chschu/buttonbox/hardware/controller.kicad_pcb

## KiCad design hardware/controller.kicad_pcb (2020-08-22)

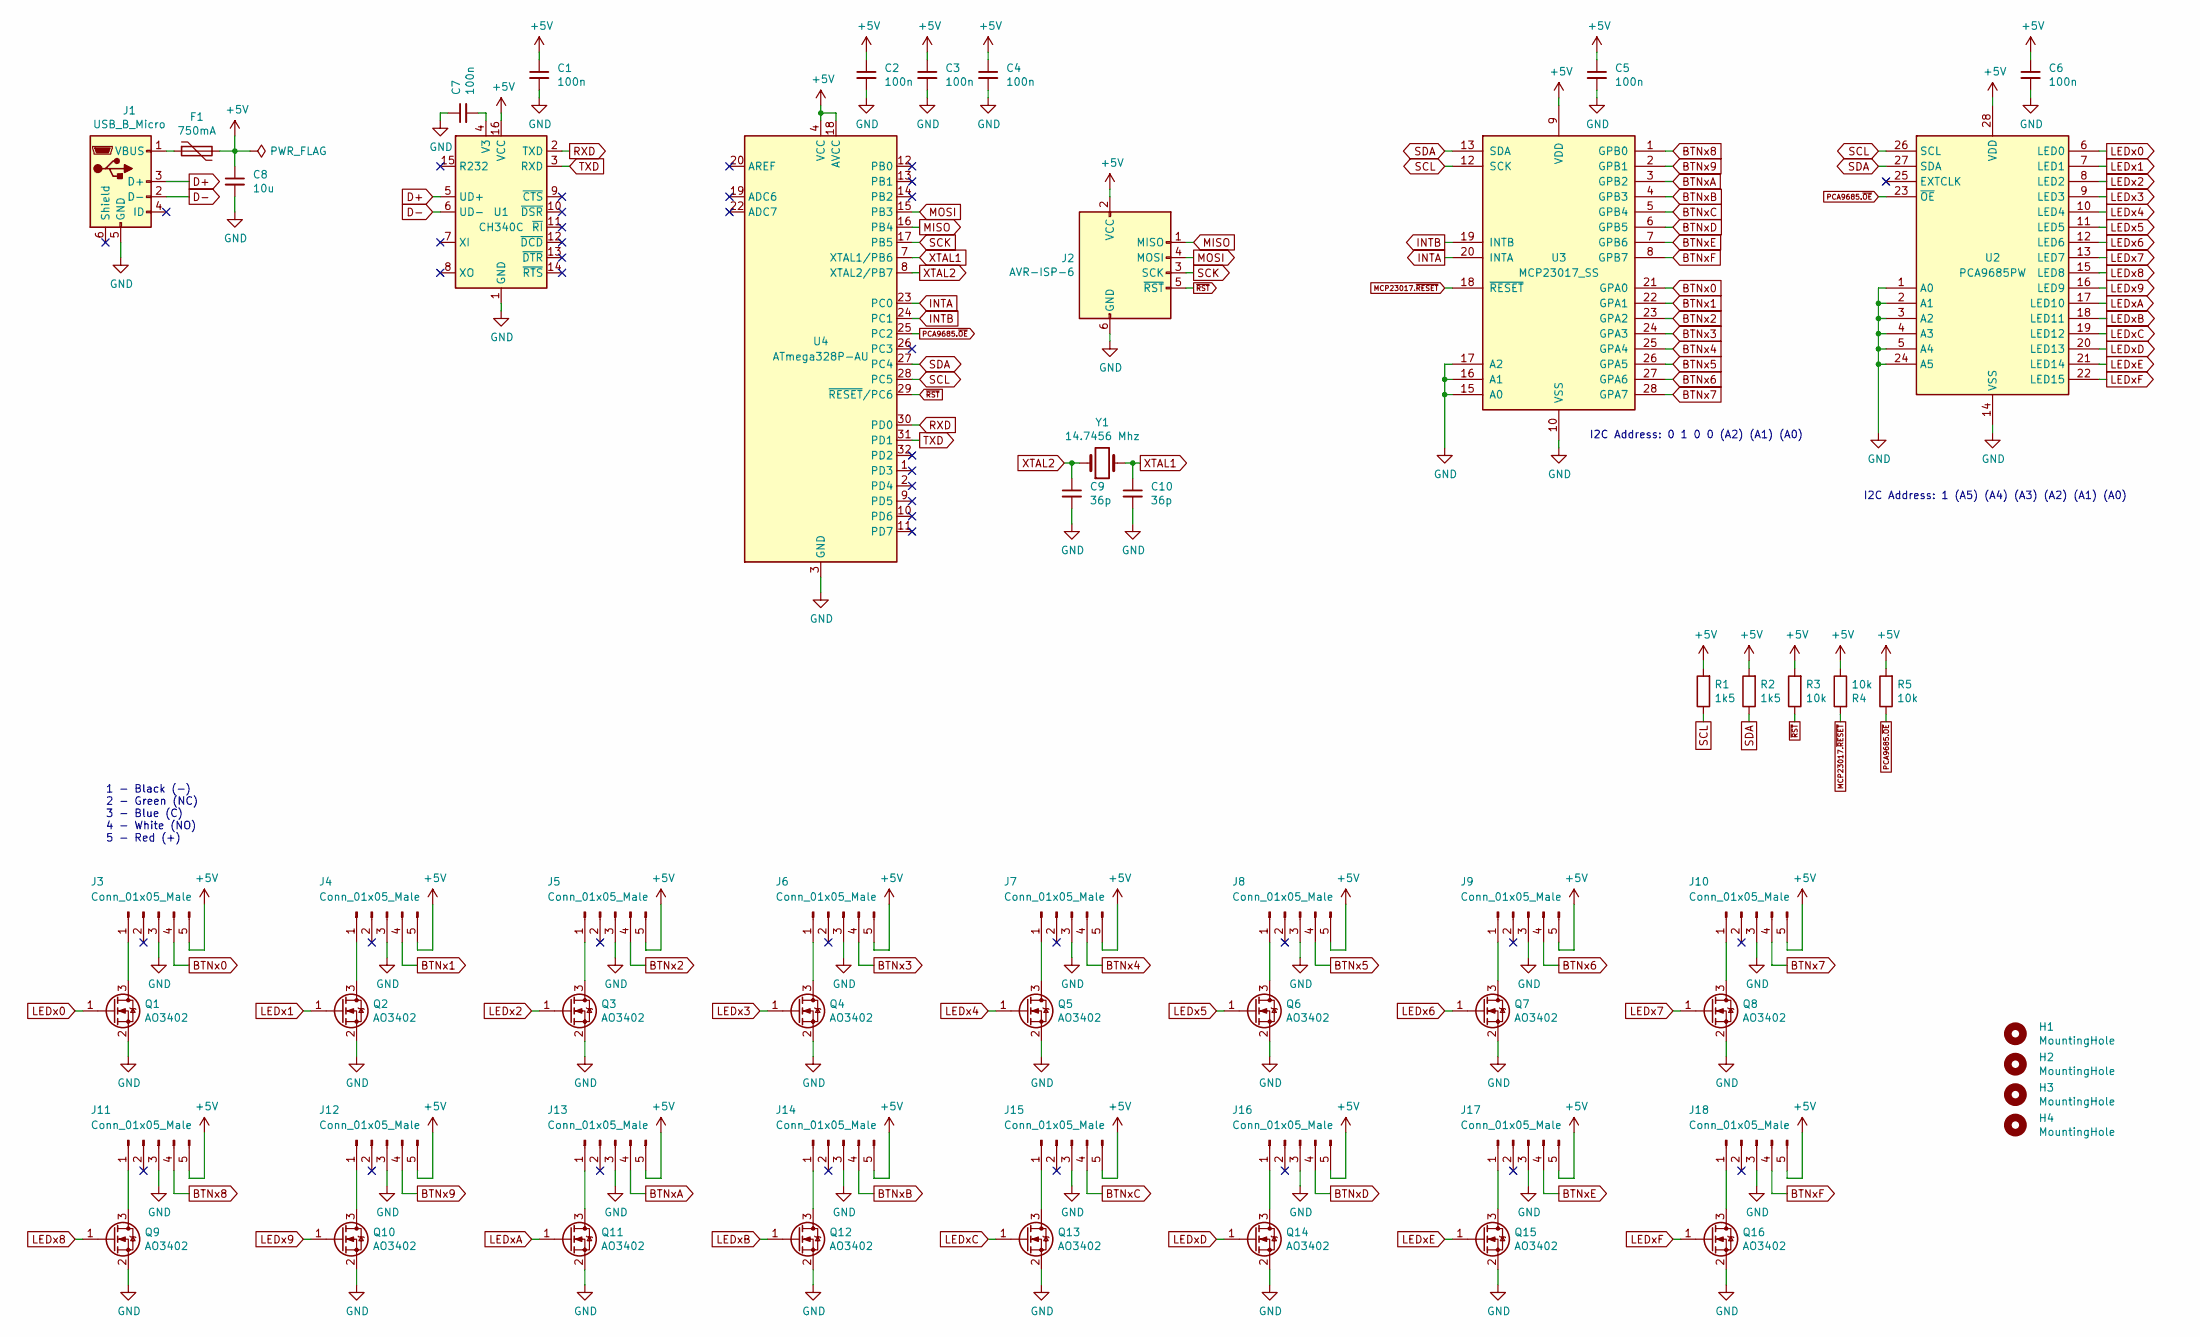
[picture p1: schematic controller.sch]

Parts:
C1, C2, C3, C4, C5, C6, C7: 100n; C_0805_2012Metric
C8: 10u; C_Disc_D6.0mm_W2.5mm_P5.00mm
C9, C10: 36p; C_0805_2012Metric
F1: 750mA; Fuse_0805_2012Metric
H1, H2, H3, H4: MountingHole; MountingHole_3.5mm
J1: USB_B_Micro; USB_Micro-B_Molex-105017-0001
J2: AVR-ISP-6; PinHeader_2x03_P2.54mm_Vertical
J3, J4, J5, J6, J7, J8, J9, J10, J11, J12, J13, J14, J15, J16, J17, J18: Conn_01x05_Male; JST_XH_B5B-XH-A_1x05_P2.50mm_Vertical
Q1, Q2, Q3, Q4, Q5, Q6, Q7, Q8, Q9, Q10, Q11, Q12, Q13, Q14, Q15, Q16: AO3402; SOT-23
R1, R2: 1k5; R_0805_2012Metric
R3, R4, R5: 10k; R_0805_2012Metric
U1: CH340C; SOIC-16_3.9x9.9mm_P1.27mm
U2: PCA9685PW; TSSOP-28_4.4x9.7mm_P0.65mm
U3: MCP23017_SS; SSOP-28_5.3x10.2mm_P0.65mm
U4: ATmega328P-AU; TQFP-32_7x7mm_P0.8mm
Y1: 14.7456 Mhz; Crystal_SMD_HC49-SD

Connections:
+5V: C1.1, C2.1, C3.1, C4.1, C5.1, C6.1, C8.1, F1.2, J2.2 (VCC), J3.5, J4.5, J5.5, J6.5, J7.5, J8.5, J9.5, J10.5, J11.5, J12.5, J13.5, J14.5, J15.5, J16.5, J17.5, J18.5, R1.2, R2.2, R3.2, R4.1, R5.2, U1.16 (VCC), U2.28 (VDD), U3.9 (VDD), U4.4 (VCC), U4.6 (VCC), U4.18 (AVCC)
BTNx0: J3.4, U3.21 (GPA0)
BTNx1: J4.4, U3.22 (GPA1)
BTNx2: J5.4, U3.23 (GPA2)
BTNx3: J6.4, U3.24 (GPA3)
BTNx4: J7.4, U3.25 (GPA4)
BTNx5: J8.4, U3.26 (GPA5)
BTNx6: J9.4, U3.27 (GPA6)
BTNx7: J10.4, U3.28 (GPA7)
BTNx8: J11.4, U3.1 (GPB0)
BTNx9: J12.4, U3.2 (GPB1)
BTNxA: J13.4, U3.3 (GPB2)
BTNxB: J14.4, U3.4 (GPB3)
BTNxC: J15.4, U3.5 (GPB4)
BTNxD: J16.4, U3.6 (GPB5)
BTNxE: J17.4, U3.7 (GPB6)
BTNxF: J18.4, U3.8 (GPB7)
D+: J1.3 (D+), U1.5 (UD+)
D-: J1.2 (D-), U1.6 (UD-)
GND: C1.2, C2.2, C3.2, C4.2, C5.2, C6.2, C7.1, C8.2, C9.2, C10.2, J1.5 (GND), J2.6 (GND), J3.3, J4.3, J5.3, J6.3, J7.3, J8.3, J9.3, J10.3, J11.3, J12.3, J13.3, J14.3, J15.3, J16.3, J17.3, J18.3, Q1.2 (S), Q2.2 (S), Q3.2 (S), Q4.2 (S), Q5.2 (S), Q6.2 (S), Q7.2 (S), Q8.2 (S), Q9.2 (S), Q10.2 (S), Q11.2 (S), Q12.2 (S), Q13.2 (S), Q14.2 (S), Q15.2 (S), Q16.2 (S), U1.1 (GND), U2.1 (A0), U2.2 (A1), U2.3 (A2), U2.4 (A3), U2.5 (A4), U2.14 (VSS), U2.24 (A5), U3.10 (VSS), U3.15 (A0), U3.16 (A1), U3.17 (A2), U4.3 (GND), U4.5 (GND), U4.21 (GND)
INTA: U3.20 (INTA), U4.23 (PC0)
INTB: U3.19 (INTB), U4.24 (PC1)
LEDx0: Q1.1 (G), U2.6 (LED0)
LEDx1: Q2.1 (G), U2.7 (LED1)
LEDx2: Q3.1 (G), U2.8 (LED2)
LEDx3: Q4.1 (G), U2.9 (LED3)
LEDx4: Q5.1 (G), U2.10 (LED4)
LEDx5: Q6.1 (G), U2.11 (LED5)
LEDx6: Q7.1 (G), U2.12 (LED6)
LEDx7: Q8.1 (G), U2.13 (LED7)
LEDx8: Q9.1 (G), U2.15 (LED8)
LEDx9: Q10.1 (G), U2.16 (LED9)
LEDxA: Q11.1 (G), U2.17 (LED10)
LEDxB: Q12.1 (G), U2.18 (LED11)
LEDxC: Q13.1 (G), U2.19 (LED12)
LEDxD: Q14.1 (G), U2.20 (LED13)
LEDxE: Q15.1 (G), U2.21 (LED14)
LEDxF: Q16.1 (G), U2.22 (LED15)
MCP23017.~RESET: R4.2, U3.18 (~RESET~)
MISO: J2.1 (MISO), U4.16 (PB4)
MOSI: J2.4 (MOSI), U4.15 (PB3)
unnamed: C7.2, U1.4 (V3)
unnamed: F1.1, J1.1 (VBUS)
unnamed: J3.1, Q1.3 (D)
unnamed: J4.1, Q2.3 (D)
unnamed: J5.1, Q3.3 (D)
unnamed: J6.1, Q4.3 (D)
unnamed: J7.1, Q5.3 (D)
unnamed: J8.1, Q6.3 (D)
unnamed: J9.1, Q7.3 (D)
unnamed: J10.1, Q8.3 (D)
unnamed: J11.1, Q9.3 (D)
unnamed: J12.1, Q10.3 (D)
unnamed: J13.1, Q11.3 (D)
unnamed: J14.1, Q12.3 (D)
unnamed: J15.1, Q13.3 (D)
unnamed: J16.1, Q14.3 (D)
unnamed: J17.1, Q15.3 (D)
unnamed: J18.1, Q16.3 (D)
PCA9685.~OE: R5.1, U2.23 (~OE), U4.25 (PC2)
RXD: U1.2 (TXD), U4.30 (PD0)
SCK: J2.3 (SCK), U4.17 (PB5)
SCL: R1.1, U2.26 (SCL), U3.12 (SCK), U4.28 (PC5)
SDA: R2.1, U2.27 (SDA), U3.13 (SDA), U4.27 (PC4)
TXD: U1.3 (RXD), U4.31 (PD1)
XTAL1: C10.1, U4.7 (XTAL1/PB6), Y1.2
XTAL2: C9.1, U4.8 (XTAL2/PB7), Y1.1
~RST: J2.5 (~RST), R3.1, U4.29 (~RESET~/PC6)

Notes on the sheet:
I2C Address: 1 (A5) (A4) (A3) (A2) (A1) (A0)
I2C Address: 0 1 0 0 (A2) (A1) (A0)
1 - Black (-) 2 - Green (NC) 3 - Blue (C) 4 - White (NO) 5 - Red (+)

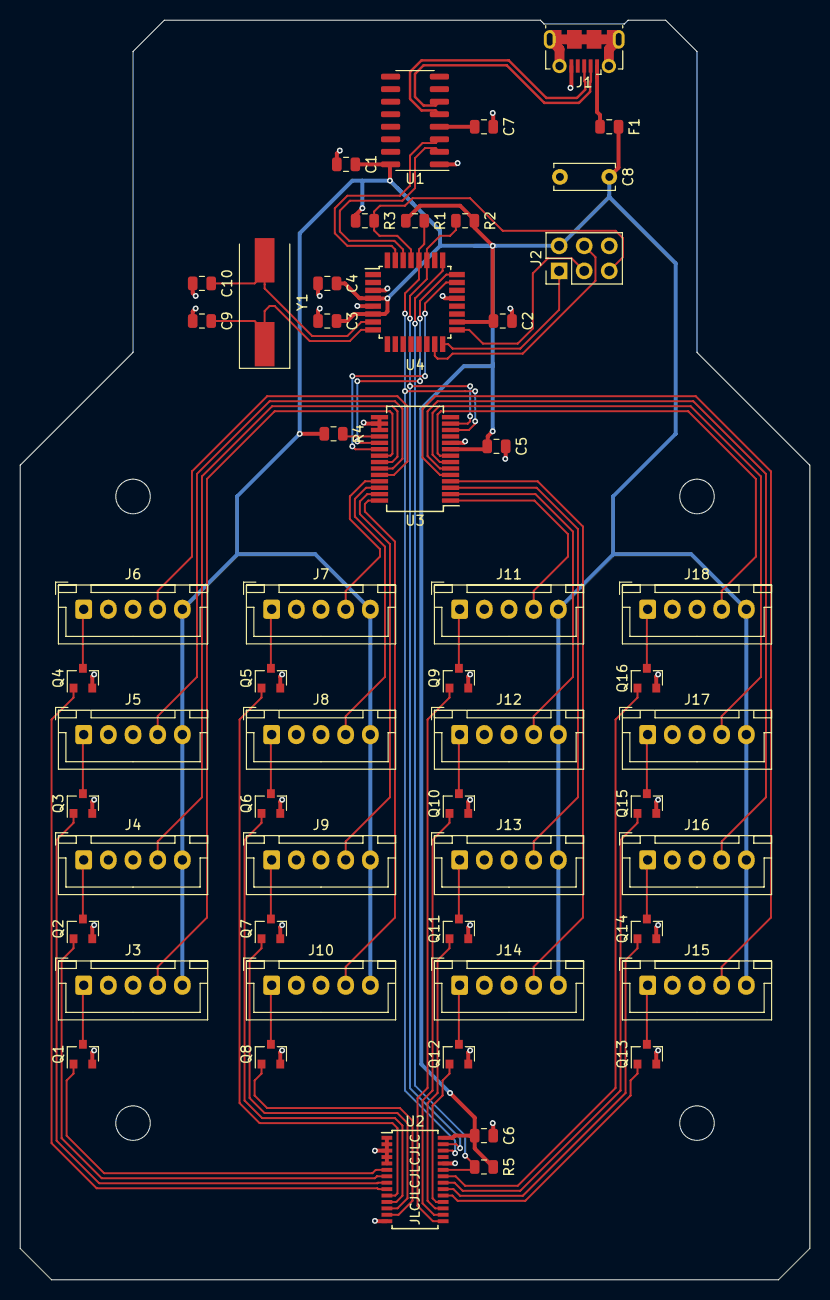
[picture p2: board controller.kicad_pcb from above]

Board: 2 copper layers, 80.0 x 127.6 mm, 59 parts (0 on the bottom side), 68 nets.
