chschu/buttonbox/(commit log)

2020-02-04 add schematic
    [ledcontrol.sch]
2020-02-07 rename files, update library references
    [controller.sch]
2020-02-10 connect buttons' NO to GND (MCP23017 has configurable internal pull-up resistors)
    [controller.sch]
2020-02-10 small schematic layout fixes
    [controller.sch]
2020-03-26 switch to ESP32, implement timerless blinker
2020-04-07 switch to ATmega8, use shorter serial protocol, add PCA9685 stuff, use MCP23017 for buttons (not debounced yet)
    [main.cpp, transform.h]
2020-04-13 simplify initialization animation, change fuses to reduce start-up time
2020-04-14 use ATmega8, add PCB (before automatic rounting)
    [controller.kicad_pcb, controller.sch]
2020-08-22 fix pull-up resistors: MCP23017.~RESET is always pulled high; PCA9685.~OE is pulled high but can be driven low by PC2
    [controller.sch]
2020-08-22 fix capitalization of board
2020-08-22 use board_hardware.* settings to define fuses
2020-08-22 use 36pF capacitors for crystal
    [controller.kicad_pcb, controller.sch]
2020-08-22 use macOS CH340 driver
2020-08-22 manually define fuses because low power oscillator seems to be more stable when touching the board
2020-08-22 increase I2C clock frequency
2020-08-22 add render call to Blinker::attach(), remove unused code
2020-08-22 implement own Debouncer without Arduino dependency; avoid using millis() to save space
    [main.cpp]
2020-08-22 use correct bit constants (same value)
    [main.cpp]
2020-08-22 update schematic with separate connectors for LEDs and buttons
    [controller.sch]
2020-08-22 remove test points
    [controller.sch]
2020-08-22 create routing-friendly PCB layout and route it manually
    [controller.kicad_pcb, controller.sch]
2020-08-22 add configurable and persistent mappings between physical connector number and logical value to support reduced number of connectors
2020-08-22 change USB connector, finalize PCB shape
    [controller.kicad_pcb, controller.sch]
2020-08-22 fix assignment of SCL and SDA pins on ATmega328p
    [controller.kicad_pcb, controller.sch]
2020-08-22 initialize EEPROM with all 255 (no connectors mapped); enter config mode if no connectors are mapped yet
2020-08-22 export Gerber and Drill files
    [controller-B_Cu.gbr, controller-B_Mask.gbr, controller-B_Paste.gbr, controller-B_SilkS.gbr, controller-Edge_Cuts.gbr, controller-F_Cu.gbr, controller-F_Mask.gbr, controller-F_Paste.gbr]
2020-08-22 fix polyfuse rating
    [controller.sch]
2020-08-22 iterate over mapped connectors only
2020-08-22 skip initialization of Serial in config mode
    [main.cpp]
2020-08-29 reset I2C bus at startup to reset stuck PCA9685 during development
    [main.cpp]
2020-08-30 use AVR UART for serial communication (smaller binary)
2020-08-31 remove Arduino, use AVR Timer0 for timing
2020-09-01 use 16 bit timer (Timer1) to reduce number of interrupts
2020-09-03 restore interrupt flag as soon as possible
2020-09-06 change fuses to match smaller bootloader size, use verbose syntax to specify start of .text section
2020-09-06 add second nop between write to PORTB and read from PIN
